haum/24hc25/docs/presentation/robot.jpg

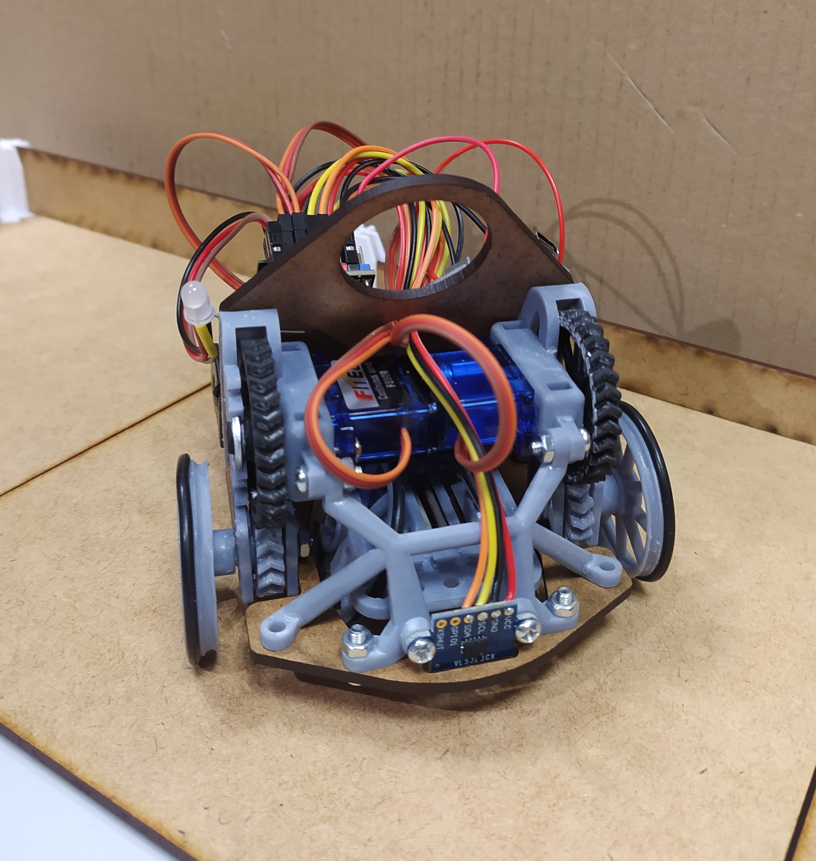
docs/presentation/robot.jpg
