haum/24hc25/docs/presentation/minotaure_orange.jpg

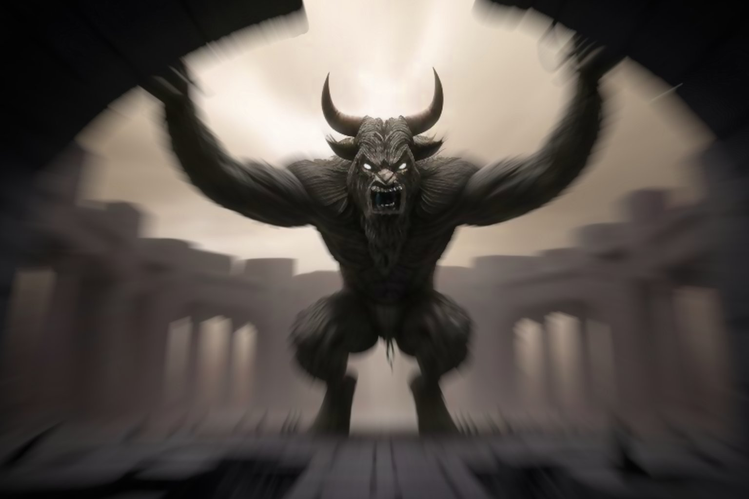
docs/presentation/minotaure_orange.jpg
