haum/24hc25/docs/notes.md

# 2025-03-11

## Sujet

* Histoire
  * ok
* Diapos
  * en cours
* Page en ligne avec les milestones (pas d'obstruction)
* Définir comment ils trouvent la page de leur robot

## Code

* Télémètre VL53L3CX
* Turtle
* Design web
* Configuration wifi
* Page de réglage des constantes

## Robot

### Prototype

* Position de la batterie
  * ok
* Position de la diode
  * ok
* Interrupteur
  * ok
* Écrou montage avant
* Clips
* Design filament vs. résine
  * tout en résine

### Série

* Soudure des platines électroniques
* Impression (résine et filament)
* Découpe
* Assemblage
* Rodage

## Labyrinthe

* Découpe des plateaux (min. 100)
* Définir la hauteur des murs
* Découpe des murs (min. 210)
* Doc dessins de labyrinthe
* Compter piliers (min. 121)
  * 130 dans le carton + 8 sur la table
* Compter piliers de fin (min. 5)
  * 1 sur la table, impression de 6 lancée

## Divers

* Canne à pêche

# 2025-03-16

## Sujet

* Histoire et diapos terminées et envoyées

## Code

* Avance, mais pas terminé

## Robot

* Deux robots entiers (moins quelques clips) imprimés, quelques soucis de qualité mais ça ira.
* Le scotch double-face est légèrement conducteur, il faut donc imprimer un support pour la platine.  Dag-Erling s'en charge.

## Labyrinthe

* Découpe des plateaux en cours

## Divers

* Séb a des cannes à pêche au canard
