haum/24hc25/docs/presentation/presentation_Haum.odp

## MinHAUMtaure

## MinHAUMtaure


Cette année, on vous propose d’être le méchant...

## MinHAUMtaure

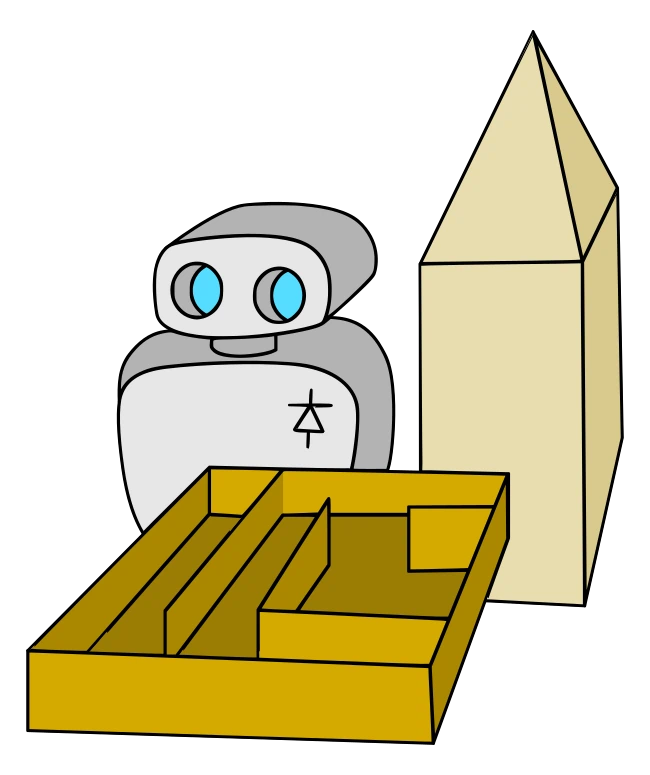
[picture p3: figure]

Le HAUM s'est pris pour Dédale. Nous vous proposons un labyrinthe dans lequel vous incarnez le MinHAUMtaure !

Vous devez le guider pour capturer son futur repas...

## MinHAUMtaure

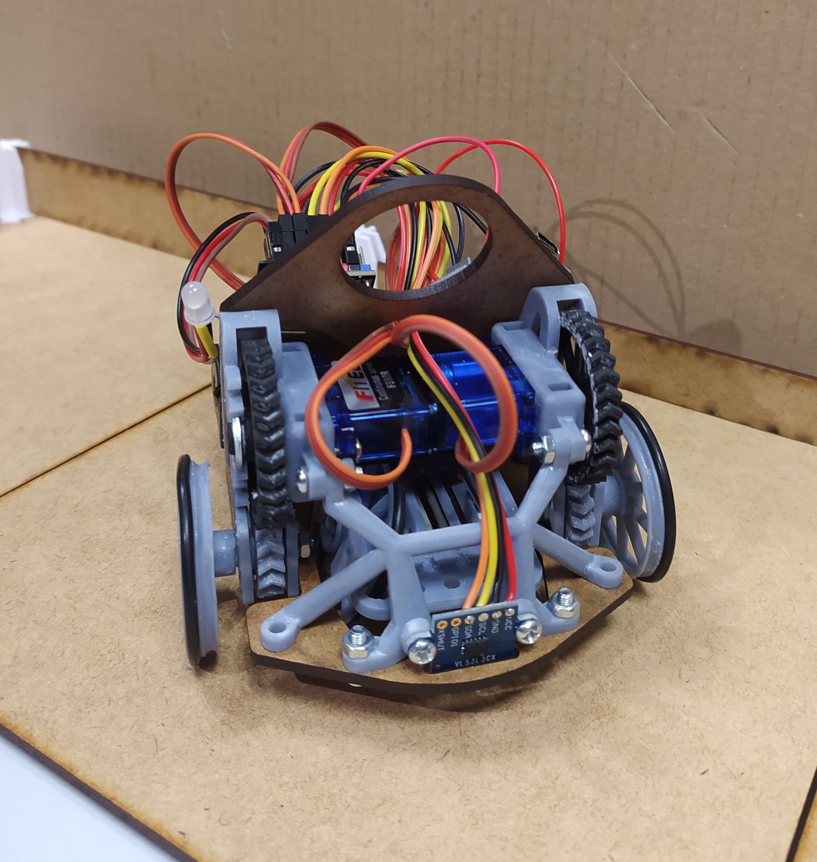
[picture p4: figure]

Pour cela, vous allez devoir apprendre à percevoir le monde à travers ses deux sens de perception. À vous de trouver lesquels et comment !

Vous devrez aussi tracer la route la plus efficace jusqu'à son but, tel un fil d'Ariane numérique dont vous aurez, bien entendu, la charge de tisser.
