haum/24hc25/meca_labyrinth/fab/PlatformPanel.dxf

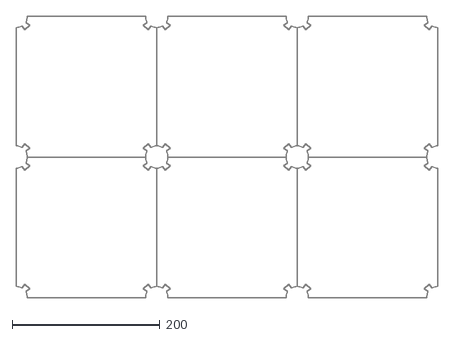
[picture p5: CAD file, 2025-03-13]
meca_labyrinth/fab/PlatformPanel.dxf
570.0 x 380.0
