haum/24hc25/meca_robot/support platine.step

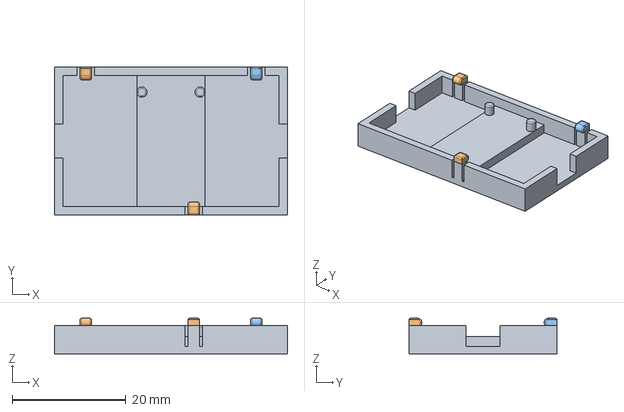
[picture p6: CAD file, 2025-03-16]
meca_robot/support platine.step
41.0 x 26.0 x 6.25 mm
