haum/24hc25/(commit log)

2025-02-05 remove les value print debug
2025-02-05 add POST FORM method for LED control
2025-02-13 Add meca_labyrinth (scad and fab files)
    [meca_labyrinth.scad]
2025-02-13 Add missing index.htm and led_index.htm in firmware
2025-02-13 Add coloris color picker in led page
2025-02-13 Replace wifi_manager by custom connect code (no AP mode)
    [wlan.py]
2025-02-14 use built in led to display connection status
2025-02-16 Fix text consistency in print_wlaninfo
    [wlan.py]
2025-02-16 Add interactive led color form in index page
2025-02-16 Add motors module
2025-02-16 Add motors websocket endpoint
2025-02-16 Add ugly UI for controlling motors in root index page
2025-03-07 Add meca_robot scad files of the first working prototype
    [haumbot.scad, haumbot_components.scad, haumbot_extparts.scad, haumbot_measure.scad, haumbot_propulsion.scad, haumbot_tools.scad]
2025-03-07 Move motors pins to the other side of the controller
2025-03-07 Change right I2C pins to avoid P8 used by builtin led
    [position.py]
2025-03-10 Add sacd files for simplified gears
    [gear_motor.scad, gear_motor.stl, gear_weel.scad, gear_weel.stl]
2025-03-10 Fix jblb's garbage in haumbot/routes.py
    [routes.py]
2025-03-10 Fix SSID name display in wlan.py
    [wlan.py]
2025-03-10 Fix code style in haumbot/led.py
    [led.py]
2025-03-10 Add timer.deinit before initializing it - propably not useful though
2025-03-10 Add info.ws websocket to receive periodical info (position & led for now)
2025-03-10 Add led color display in index page
2025-03-10 Integrate jblb_scad into regular scad files
    [gear_motor.scad, gear_motor.stl, gear_weel.scad, gear_weel.stl, haumbot_propulsion.scad]
2025-03-12 Change FDM mount of wheel gear axis
    [haumbot_propulsion.scad]
2025-03-12 Add button in haumbot_extparts.scad
    [haumbot_extparts.scad]
2025-03-12 Change back plate of robot for higher battery
    [haumbot.scad]
2025-03-12 Redesign clips
    [haumbot_components.scad]
2025-03-12 Move hole linking bracket and front structure in robot
    [haumbot.scad, haumbot_propulsion.scad]
2025-03-12 Add nut traps in front structure
    [haumbot.scad, haumbot_propulsion.scad]
2025-03-12 Bigger holes for screwing servo
    [haumbot_propulsion.scad]
2025-03-12 Fix M8 washer external size with measure on actual robot
    [haumbot_extparts.scad]
2025-03-13 dd dxf file for labyrinth tildes
    [PlatformPanel.dxf]
2025-03-13 Remove outdated api and led index pages
2025-03-13 Handle position reset error in related endpoint
    [routes.py]
2025-03-13 Add reset position button in web page
2025-03-14 Change front_strcuture to give room ti measure plate
    [haumbot.scad]
2025-03-14 Add rotation argument to change measure plate angle in the assembly
    [haumbot.scad]
2025-03-14 Add clearance for axis in clip cap
    [haumbot_components.scad]
2025-03-14 Add clip cap in measure assembly
    [haumbot_measure.scad]
2025-03-14 Modify measure base to improve it as seen on proto2
    [haumbot_measure.scad]
2025-03-14 Add functions to manage led color
2025-03-14 meno cablage robot
    [liste_cablage_robot.ods]
2025-03-15 updte mémo cablage
    [liste_cablage_robot.ods]
2025-03-16 Regroup some documents under docs/ folder
    [liste_cablage_robot.ods]
2025-03-16 Fix motor joystick with touch events
2025-03-16 Add fullscreen and close buttons in section title
2025-03-16 Support platine
    [support platine.step]
2025-03-17 Update wlan logic with led and first_connect using same autoconnect code
2025-03-18 Adjust bottom plate of the robot
    [haumbot.scad]
2025-03-18 Add i2c for rangefinder
2025-03-18 Add rangefinder i2c pinout in config page
2025-03-18 Update doc cablage
    [liste_cablage_robot.ods]
2025-03-19 Add decoding for (future) motors and wheel data from infos.ws
2025-03-19 Store motor command to be able to send it back through infos.ws
2025-03-19 Send motors and wheels messages through infos.ws
2025-03-19 Add motors command display
2025-03-19 Add wheels position display
2025-03-20 Use insertAdjacentHTML instead of innerHTML property
2025-03-21 Change management of position timer
2025-03-21 Add message saying which wheel sensor is in error
    [position.py]
2025-03-21 Add PID parameters in config section
2025-03-22 Add linear correction in rangefinder
    [config.py, rangefinder.py]
2025-03-22 Update linear correction of rangefinder live
    [rangefinder.py]
2025-03-22 Implement crude motor stopping routine if position or angle stops changing for too long while in motion
    [pilot.py]
2025-03-22 Fix the live update of parameters for the rangefinder
    [rangefinder.py]
